Deadly-pro/Omni-RISC/docs/diagrams/architecture.vivado.png

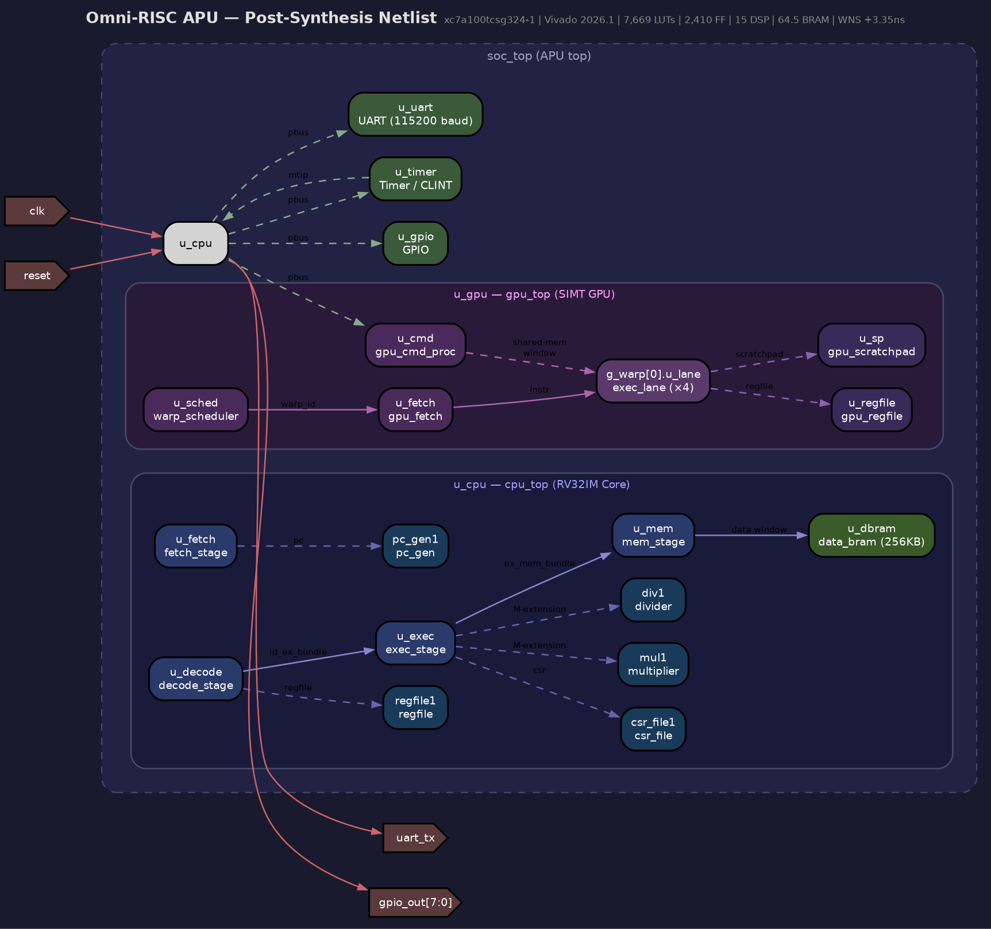
docs/diagrams/architecture.vivado.png
