Deadly-pro/Omni-RISC/hardware/rtl/gpu/gpu_cmd_proc.v

// Omni-RISC APU — GPU Command Processor
//
// Receives commands from CPU via PBUS, launches warps on GPU, and hosts the
// shared-memory window: the CPU writes kernel inputs into warp0's scratchpad
// and reads results back through HOST_DATA. Writes complete on the PBUS store
// before LAUNCH is issued (acquire for the GPU); the CPU polls active_warps to
// zero before reading results (release from the GPU).
module gpu_cmd_proc (
    input         clk,
    input         reset,
    // PBUS interface (from CPU)
    input  [31:0] pbus_addr,
    input  [31:0] pbus_wdata,
    input  [3:0]  pbus_wen,
    input         pbus_read,
    output [31:0] pbus_rdata,
    output        pbus_ready,
    // warp scheduler interface
    output [31:0] cmd_warp_pc,
    output [1:0]  cmd_warp_id,
    output        cmd_launch,
    // status
    input  [3:0]  active_warps,
    // completion interrupt: level-high when a warp just finished; cleared
    // on STATUS read (so the ISR reads STATUS, then clears msip = 0)
    output        gpu_done,
    // shared-memory window into warp0's scratchpad (128-bit = 4 lanes at one
    // word index: [31:0]=lane0, [63:32]=lane1, [95:64]=lane2, [127:96]=lane3)
    input  [127:0] host_rdata,
    output [7:0]  host_raddr,
    output [1:0]  host_wbank,
    output [7:0]  host_waddr,
    output reg [31:0] host_wdata,
    output reg        host_wen,
    // Kernel load port into gpu_fetch's imem (see the address map below).
    output        imem_we,
    output [9:0]  imem_addr,
    output [15:0] imem_data,
    // Base address for the GPU's global memory accesses (LDG/STG). The CPU points
    // the GPU at one of its own buffers; kernels then use small offsets.
    output [31:0] mem_base,
    // Debug visibility for the global-memory handshake (read at +0x30/+0x34):
    // how many transactions were started, and the live state bits. Without these
    // a stuck LDG/STG is indistinguishable from one that silently never issued.
    input  [31:0] dbg_starts,
    input  [31:0] dbg_state,
    input  [31:0] dbg_last
);

    // Command registers (memory-mapped at 0x4000_2000)
    // 0x4000_2000: warp_pc[0]
    // 0x4000_2004: warp_pc[1]
    // 0x4000_2008: warp_pc[2]
    // 0x4000_200C: warp_pc[3]
    // 0x4000_2010: launch (bit[31] = go, bit[1:0] = warp_id)
    // 0x4000_2014: result (warp0 scratchpad word 0 readback)
    // 0x4000_2018: host_win ({bank[1:0], word[7:0]} for shared-memory access)
    // 0x4000_201C: host_data (write -> scratchpad store; read -> scratchpad load)
    // 0x4000_2020: status (unlisted -> returns active_warps)
    // 0x4000_2024: imem_addr (RW, 10-bit word index)
    // 0x4000_2028: imem_data (W: write this 16-bit word to imem_addr, then
    //              auto-increment the address - a memcpy loop pushes the image)
    // 0x4000_202C: mem_base (RW: base address for LDG/STG global accesses)
    // 0x4000_2030: dbg_starts (RO: global transactions started)
    // 0x4000_2034: dbg_state  (RO: {g_is_load, g_busy, g_done, mem_wen!=0})
    reg [31:0] warp_pc [0:3];
    reg        launch_pending;
    reg [1:0]  launch_warp_id;
    reg [9:0]  host_win;
    reg [9:0]  imem_addr_r;
    reg [31:0] mem_base_r;

    // done latch: set when active_warps goes 1->0, combinational-clear on read
    reg        gpu_done_latch;
    reg        was_busy;
    wire       gpu_done_clear = pbus_read && (pbus_addr[5:0] == 6'h20);

    always @(posedge clk) begin
        if (reset) begin
            gpu_done_latch <= 1'b0;
            was_busy       <= 1'b0;
        end else begin
            was_busy <= |active_warps;
            if (gpu_done_clear)
                gpu_done_latch <= 1'b0;
            else if (was_busy && !(|active_warps))
                gpu_done_latch <= 1'b1;
        end
    end
    // combinational so the ISR's read-STATUS clears the latch before the
    // write to msip (even though the register clears on the next edge)
    assign gpu_done = gpu_done_latch & ~gpu_done_clear;

    assign pbus_ready = 1'b1;

    always @(posedge clk) begin
        if (reset) begin
            warp_pc[0] <= 32'b0;
            warp_pc[1] <= 32'b0;
            warp_pc[2] <= 32'b0;
            warp_pc[3] <= 32'b0;
            launch_pending <= 1'b0;
            launch_warp_id <= 2'b0;
            host_win       <= 10'b0;
            host_wen       <= 1'b0;
            host_wdata     <= 32'b0;
            imem_addr_r    <= 10'b0;
            mem_base_r     <= 32'b0;
        end else begin
            launch_pending <= 1'b0;
            host_wen       <= 1'b0;
            // 6-bit decode (was 5): the imem registers live at +0x24/+0x28, and a
            // 5-bit decode would alias +0x20 onto warp_pc[0].
            if (|pbus_wen && pbus_addr[31:6] == 26'h1000080) begin
                case (pbus_addr[5:0])
                    6'h00: warp_pc[0] <= pbus_wdata;
                    6'h04: warp_pc[1] <= pbus_wdata;
                    6'h08: warp_pc[2] <= pbus_wdata;
                    6'h0C: warp_pc[3] <= pbus_wdata;
                    6'h10: begin
                        if (pbus_wen[3]) begin
                            launch_pending <= pbus_wdata[31];  // go bit
                            launch_warp_id <= pbus_wdata[1:0]; // warp_id
                        end
                    end
                    6'h18: host_win <= pbus_wdata[9:0];   // bank + word select
                    6'h1C: begin
                        host_wdata <= pbus_wdata;
                        host_wen   <= 1'b1;               // store into scratchpad
                    end
                    6'h24: imem_addr_r <= pbus_wdata[9:0];
                    6'h28: imem_addr_r <= imem_addr_r + 10'b1;   // auto-increment
                    6'h2C: mem_base_r  <= pbus_wdata;
                    default: ;
                endcase
            end
        end
    end

    assign cmd_warp_pc  = warp_pc[launch_warp_id];
    assign cmd_warp_id  = launch_warp_id;
    assign cmd_launch   = launch_pending;

    // shared-memory window outputs (warp0 scratchpad)
    assign host_raddr  = host_win[7:0];
    assign host_wbank  = host_win[9:8];
    assign host_waddr  = host_win[7:0];

    // Kernel load port. imem_we is combinational off the same decode the write
    // block uses, so a store to IMEM_DATA lands in the array on that edge.
    assign imem_addr = imem_addr_r;
    assign imem_data = pbus_wdata[15:0];
    assign imem_we   = (|pbus_wen) && (pbus_addr[31:6] == 26'h1000080) &&
                       (pbus_addr[5:0] == 6'h28);
    assign mem_base  = mem_base_r;

    // readback
    wire [31:0] rdata_0 = warp_pc[0];
    wire [31:0] rdata_1 = warp_pc[1];
    wire [31:0] rdata_2 = warp_pc[2];
    wire [31:0] rdata_3 = warp_pc[3];
    wire [31:0] rdata_10 = {launch_pending, 29'b0, launch_warp_id};
    wire [31:0] rdata_14 = host_rdata[31:0];   // warp0 scratchpad word 0 readback
    wire [31:0] rdata_18 = {22'b0, host_win};
    wire [31:0] rdata_1C = host_rdata[host_win[9:8]*32 +: 32]; // lane word read
    wire [31:0] rdata_def = {28'b0, active_warps};

    assign pbus_rdata = (pbus_addr[31:6] != 26'h1000080) ? 32'b0 :
                        (pbus_addr[5:0] == 6'h00) ? rdata_0 :
                        (pbus_addr[5:0] == 6'h04) ? rdata_1 :
                        (pbus_addr[5:0] == 6'h08) ? rdata_2 :
                        (pbus_addr[5:0] == 6'h0C) ? rdata_3 :
                        (pbus_addr[5:0] == 6'h10) ? rdata_10 :
                        (pbus_addr[5:0] == 6'h14) ? rdata_14 :
                        (pbus_addr[5:0] == 6'h18) ? rdata_18 :
                        (pbus_addr[5:0] == 6'h1C) ? rdata_1C :
                        (pbus_addr[5:0] == 6'h24) ? {22'b0, imem_addr_r} :
                        (pbus_addr[5:0] == 6'h2C) ? mem_base_r :
                        (pbus_addr[5:0] == 6'h30) ? dbg_starts :
                        (pbus_addr[5:0] == 6'h34) ? dbg_state :
                        (pbus_addr[5:0] == 6'h38) ? dbg_last :
                        rdata_def;

endmodule
