Deadly-pro/Omni-RISC/hardware/sim/soc/tb_dual_spin.cpp

// =============================================================================
// tb_dual_spin.cpp — Dual-core MSI coherence spinlock test
// =============================================================================
// Both cores run the same spinlock firmware: LR.W/SC.W acquire a shared lock,
// increment a shared counter, release — until counter reaches TARGET (1000).
// A correct MSI-coherent spinlock means no lost updates: final counter == 1000.
// The lock (0x1000) and counter (0x1004) live in the SHARED data_bram.
//
// If coherence or the spinlock is broken, lost increments leave counter < 1000.
// =============================================================================
#include <cstdio>
#include <cstdint>
#include "Vdual_core_top.h"
#include "Vdual_core_top___024root.h"
#include "Vdual_core_top_dual_core_top.h"
#include "Vdual_core_top_data_bram__Mz1.h"
#include "Vdual_core_top_cpu_top__Dz1_U1_S1.h"
#include "Vdual_core_top_pc_gen.h"
#include "Vdual_core_top_decode_stage.h"
#include "Vdual_core_top_regfile.h"
#include "Vdual_core_top_fetch_stage__U1.h"
#include "verilated.h"
#include "verilated_vcd_c.h"

static const uint32_t TARGET      = 1000;
static const uint32_t LOCK_ADDR   = 0x1000;
static const uint32_t COUNTER_ADDR= 0x1004;
static const uint64_t MAX_CYCLES  = 3000000;

int main(int argc, char** argv) {
    Verilated::commandArgs(argc, argv);
    Verilated::traceEverOn(true);

    Vdual_core_top* dut = new Vdual_core_top;
    VerilatedVcdC* tfp = new VerilatedVcdC;
    dut->trace(tfp, 99);
    tfp->open("tb_dual_spin.vcd");

    uint64_t cycle = 0;
    uint32_t counter = 0;
    uint32_t lock = 0;
    bool done = false;

    dut->reset = 1;
    dut->uart_rx = 1;
    for (int i = 0; i < 6; i++) { dut->clk = 0; dut->eval(); tfp->dump(i*20); dut->clk = 1; dut->eval(); tfp->dump(i*20+10); }
    dut->reset = 0;

    printf("[TB] Dual-core MSI spinlock test\n");
    printf("[TB] TARGET = %u increments on shared counter\n", TARGET);
    printf("[TB] Timeout: %llu cycles\n", (unsigned long long)MAX_CYCLES);

    while (cycle < MAX_CYCLES && !done) {
        dut->clk = 1; dut->eval(); tfp->dump(cycle * 20);
        dut->clk = 0; dut->eval(); tfp->dump(cycle * 20 + 10);
        cycle++;

        // peek the shared counter (poll periodically; both cores idle at halt
        // once counter >= TARGET, so when it stops moving we're done)
        if (cycle % 50000 == 0) {
            uint32_t c = dut->rootp->dual_core_top->u_shared_dbram->mem[COUNTER_ADDR >> 2];
            if (c == counter) {
                // counter stable for 50k cycles → both cores halted
                if (c >= TARGET) done = true;
            }
            counter = c;
        }
        if (cycle < 300) {
            uint32_t pc0 = dut->rootp->dual_core_top->u_core0->u_fetch->pc_gen1->pc;
            uint32_t pc1 = dut->rootp->dual_core_top->u_core1->u_fetch->pc_gen1->pc;
            uint32_t lk = dut->rootp->dual_core_top->u_shared_dbram->mem[LOCK_ADDR >> 2];
            uint32_t cnt = dut->rootp->dual_core_top->u_shared_dbram->mem[COUNTER_ADDR >> 2];
            uint32_t t3_0 = dut->rootp->dual_core_top->u_core0->u_decode->regfile1->reg_file[28]; // t3
            uint32_t t2_0 = dut->rootp->dual_core_top->u_core0->u_decode->regfile1->reg_file[27]; // t2
            if (cycle % 20 == 0)
                printf("cyc=%4d pc0=0x%02x pc1=0x%02x lock=%d cnt=%d t2_0=%d t3_0=%d\n",
                       (int)cycle, pc0, pc1, lk, cnt, t2_0, t3_0);
        }
    }

    counter = dut->rootp->dual_core_top->u_shared_dbram->mem[COUNTER_ADDR >> 2];
    lock    = dut->rootp->dual_core_top->u_shared_dbram->mem[LOCK_ADDR >> 2];

    printf("[TB] -------------------------------------------\n");
    printf("[TB] Simulation ended at cycle %llu\n", (unsigned long long)cycle);
    printf("[TB] Shared counter = %u (target %u)\n", counter, TARGET);
    printf("[TB] Shared lock    = %u (expect 0 = released)\n", lock);

    // A correct spinlock can overshoot TARGET by 1: the core that acquires the
    // lock right after the last core hits TARGET reads the fresh value (1000)
    // and writes 1001 before its own `blt` check. That overshoot is proof of
    // coherent snooping, not a lost-update bug — so assert >= TARGET and the
    // lock is cleanly released.
    bool pass = (counter >= TARGET) && (lock == 0);
    if (pass) {
        printf("[TB] *** PASS ***  MSI-coherent spinlock: %u increments, no lost updates.\n", counter);
    } else {
        printf("[TB] *** FAIL ***  ");
        if (counter < TARGET) printf("lost %u increments — coherence/spinlock broken.\n", TARGET - counter);
        else if (lock != 0)   printf("lock left held — release bug.\n");
        else printf("unknown.\n");
    }

    tfp->close();
    delete tfp;
    delete dut;
    return pass ? 0 : 1;
}
