Deadly-pro/Omni-RISC/hardware/sim/cpu/tb_cpu_top.cpp

// =============================================================================
// tb_cpu_top.cpp — Integration testbench for the Omni-RISC 5-stage CPU
// =============================================================================
// Two independent phases, each a fresh CPU instance loaded with its own
// hand-verified program (assembled with riscv-none-elf-as, encodings embedded):
//
//   PHASE 1 — First boot / control flow
//     Straight-line ALU, JAL link value, taken BEQ, and BOTH wrong-path kills
//     (decode flush + fetch squash). x28-x31 are canaries: nonzero = a squashed
//     instruction escaped and retired.
//
//   PHASE 2 — Memory subsystem (LSU + data_bram + WB load aligner)
//     SW/LW word round trip, LB/LBU/LH/LHU sign- and zero-extension, and
//     byte/half store-lane masking (SB/SH must touch only their lanes, leaving
//     the rest of the word intact). This is the first real exercise of the
//     load/store decode path, EX address gen, and the Option-B split where the
//     raw word rides BRAM->WB and the aligner slices it in WB.
//
// Both phases peek the architectural regfile through the Verilator hierarchy
// (reg_file is marked /* verilator public */).
// =============================================================================

#include <cstdio>
#include <cstdint>
#include "Vcpu_top.h"
#include "Vcpu_top___024root.h"
#include "Vcpu_top_cpu_top.h"
#include "Vcpu_top_decode_stage.h"
#include "Vcpu_top_regfile.h"
#include "Vcpu_top_mem_stage.h"
#include "Vcpu_top_data_bram.h"
#include "verilated.h"
#include "verilated_vcd_c.h"

#ifndef VCD_FILE
#define VCD_FILE "tb_cpu_top.vcd"
#endif

static int checks = 0;
static int fails = 0;

// -----------------------------------------------------------------------------
// A single CPU instance with its own trace. program.hex must exist on disk
// BEFORE the model is constructed — $readmemh runs in instr_bram's initial
// block at time zero.
// -----------------------------------------------------------------------------
struct Sim {
    VerilatedContext* ctx;
    Vcpu_top*         dut;
    VerilatedVcdC*    tfp;
    vluint64_t        t = 0;

    Sim(const char* vcd) {
        // Each instance gets its own context — Verilator refuses to trace two
        // models through one shared (default) context.
        ctx = new VerilatedContext;
        ctx->traceEverOn(true);
        dut = new Vcpu_top(ctx);
        tfp = new VerilatedVcdC;
        dut->trace(tfp, 99);
        tfp->open(vcd);
    }
    ~Sim() { tfp->close(); delete tfp; delete dut; delete ctx; }

    void tick() {
        dut->clk = 0; dut->eval(); tfp->dump(t++);
        dut->clk = 1; dut->eval(); tfp->dump(t++);
    }
    void run(int reset_cyc, int run_cyc) {
        dut->reset = 1;
        for (int i = 0; i < reset_cyc; i++) tick();
        dut->reset = 0;
        for (int i = 0; i < run_cyc; i++) tick();
    }
    uint32_t reg(int idx) {
        // root -> cpu_top -> u_decode -> regfile1 -> reg_file[idx]
        return dut->rootp->cpu_top->u_decode->regfile1->reg_file[idx];
    }
    uint32_t mem(int idx) {
        // root -> cpu_top -> u_mem -> u_dbram -> mem[idx]
        return dut->rootp->cpu_top->u_mem->u_dbram->mem[idx];
    }
};

static void write_hex(const uint32_t* prog, int n) {
    FILE* f = fopen("program.hex", "w");
    if (!f) { printf("ERROR: cannot write program.hex\n"); exit(2); }
    for (int i = 0; i < 1024; i++)
        fprintf(f, "%08X\n", i < n ? prog[i] : 0x00000013u); // NOP fill
    fclose(f);
}

static void check_reg(Sim& s, int idx, uint32_t expect, const char* why) {
    checks++;
    uint32_t got = s.reg(idx);
    if (got != expect) {
        fails++;
        printf("FAIL  x%-2d = 0x%08X, expected 0x%08X  (%s)\n", idx, got, expect, why);
    } else {
        printf("pass  x%-2d = 0x%08X  (%s)\n", idx, got, why);
    }
}

static void check_mem(Sim& s, int idx, uint32_t expect, const char* why) {
    checks++;
    uint32_t got = s.mem(idx);
    if (got != expect) {
        fails++;
        printf("FAIL  mem[0x%03X] = 0x%08X, expected 0x%08X  (%s)\n", idx*4, got, expect, why);
    } else {
        printf("pass  mem[0x%03X] = 0x%08X  (%s)\n", idx*4, got, why);
    }
}

// -----------------------------------------------------------------------------
// PHASE 1 — control flow / first boot
// -----------------------------------------------------------------------------
static void phase_boot() {
    uint32_t prog[64];
    int i = 0;
    prog[i++] = 0x00500093; // 0x00: addi x1, x0, 5
    prog[i++] = 0x00700113; // 0x04: addi x2, x0, 7
    prog[i++] = 0x00000013; // 0x08: nop            (2-NOP rule: no forwarding)
    prog[i++] = 0x00000013; // 0x0C: nop
    prog[i++] = 0x002081B3; // 0x10: add  x3, x1, x2        -> x3 = 12
    prog[i++] = 0x00C002EF; // 0x14: jal  x5, +12           -> 0x20, link = 0x18
    prog[i++] = 0x11100F93; // 0x18: addi x31, x0, 0x111    POISON (decode-flush slot)
    prog[i++] = 0x22200F13; // 0x1C: addi x30, x0, 0x222    POISON (fetch-squash slot)
    prog[i++] = 0x00100313; // 0x20: addi x6, x0, 1         JAL target
    prog[i++] = 0x00000013; // 0x24: nop
    prog[i++] = 0x00000013; // 0x28: nop
    prog[i++] = 0x00108663; // 0x2C: beq  x1, x1, +12       taken -> 0x38
    prog[i++] = 0x33300E93; // 0x30: addi x29, x0, 0x333    POISON (decode-flush slot)
    prog[i++] = 0x44400E13; // 0x34: addi x28, x0, 0x444    POISON (fetch-squash slot)
    prog[i++] = 0x00900393; // 0x38: addi x7, x0, 9         branch target
    write_hex(prog, i);

    Sim s(VCD_FILE);
    s.run(3, 80);

    printf("\n--- PHASE 1: control flow ---\n");
    check_reg(s,  0, 0x00000000, "x0 is hardwired zero");
    check_reg(s,  1, 0x00000005, "addi x1, x0, 5");
    check_reg(s,  2, 0x00000007, "addi x2, x0, 7");
    check_reg(s,  3, 0x0000000C, "add x3, x1, x2 — first-boot check");
    check_reg(s,  5, 0x00000018, "JAL link = pc+4 via WB jump mux");
    check_reg(s,  6, 0x00000001, "instruction at JAL target executed");
    check_reg(s,  7, 0x00000009, "instruction at BEQ target executed");
    check_reg(s, 31, 0x00000000, "JAL wrong-path #1 killed by decode flush");
    check_reg(s, 30, 0x00000000, "JAL wrong-path #2 killed by fetch squash");
    check_reg(s, 29, 0x00000000, "BEQ wrong-path #1 killed by decode flush");
    check_reg(s, 28, 0x00000000, "BEQ wrong-path #2 killed by fetch squash");
}

// -----------------------------------------------------------------------------
// PHASE 2 — memory subsystem (assembled from /tmp/ldst.S, encodings verified)
//   base x1 = 0x100.  Word A = 0x12345678, Word B = 0xFFFFFF80 (-128).
// -----------------------------------------------------------------------------
static void phase_mem() {
    uint32_t prog[64];
    int i = 0;
    prog[i++] = 0x10000093; // li   x1, 0x100          base addr
    prog[i++] = 0x00000013; // nop
    prog[i++] = 0x00000013; // nop
    prog[i++] = 0x12345137; // lui  x2, 0x12345
    prog[i++] = 0x00000013; // nop   (space lui->addi: no forwarding yet)
    prog[i++] = 0x00000013; // nop
    prog[i++] = 0x67810113; // addi x2, x2, 0x678       x2 = 0x12345678
    prog[i++] = 0x00000013; // nop
    prog[i++] = 0x00000013; // nop
    prog[i++] = 0x0020A023; // sw   x2, 0(x1)           mem[A] = 0x12345678
    prog[i++] = 0x00000013; // nop
    prog[i++] = 0x00000013; // nop
    prog[i++] = 0x0000A183; // lw   x3, 0(x1)           0x12345678
    prog[i++] = 0x0000C203; // lbu  x4, 0(x1)           0x00000078
    prog[i++] = 0x0030C283; // lbu  x5, 3(x1)           0x00000012
    prog[i++] = 0x0020D303; // lhu  x6, 2(x1)           0x00001234
    prog[i++] = 0x00000013; // nop
    prog[i++] = 0x00000013; // nop
    prog[i++] = 0xF8000393; // li   x7, -128            0xFFFFFF80
    prog[i++] = 0x00000013; // nop
    prog[i++] = 0x00000013; // nop
    prog[i++] = 0x0070A223; // sw   x7, 4(x1)           mem[B] = 0xFFFFFF80
    prog[i++] = 0x00000013; // nop
    prog[i++] = 0x00000013; // nop
    prog[i++] = 0x00408403; // lb   x8,  4(x1)          0xFFFFFF80  (sign)
    prog[i++] = 0x0040C483; // lbu  x9,  4(x1)          0x00000080  (zero)
    prog[i++] = 0x00409503; // lh   x10, 4(x1)          0xFFFFFF80  (sign)
    prog[i++] = 0x0040D583; // lhu  x11, 4(x1)          0x0000FF80  (zero)
    prog[i++] = 0x00000013; // nop
    prog[i++] = 0x00000013; // nop
    prog[i++] = 0x0AB00613; // li   x12, 0xAB
    prog[i++] = 0x00000013; // nop
    prog[i++] = 0x00000013; // nop
    prog[i++] = 0x00C080A3; // sb   x12, 1(x1)          byte1 lane only
    prog[i++] = 0x00000013; // nop
    prog[i++] = 0x00000013; // nop
    prog[i++] = 0x0000A683; // lw   x13, 0(x1)          0x1234AB78
    prog[i++] = 0x00000013; // nop
    prog[i++] = 0x00000013; // nop
    prog[i++] = 0xFFF00713; // li   x14, -1             0xFFFFFFFF
    prog[i++] = 0x00000013; // nop
    prog[i++] = 0x00000013; // nop
    prog[i++] = 0x00E0A423; // sw   x14, 8(x1)          mem[C] = 0xFFFFFFFF
    prog[i++] = 0x00000013; // nop
    prog[i++] = 0x00000013; // nop
    prog[i++] = 0x12300793; // li   x15, 0x123
    prog[i++] = 0x00000013; // nop
    prog[i++] = 0x00000013; // nop
    prog[i++] = 0x00F09423; // sh   x15, 8(x1)          low half lane only
    prog[i++] = 0x00000013; // nop
    prog[i++] = 0x00000013; // nop
    prog[i++] = 0x0080A803; // lw   x16, 8(x1)          0xFFFF0123
    prog[i++] = 0x00000013; // nop
    prog[i++] = 0x00000013; // nop
    prog[i++] = 0x0000006F; // halt: j halt
    write_hex(prog, i);

    Sim s("tb_cpu_top_mem.vcd");
    s.run(3, 130);

    printf("\n--- PHASE 2: memory subsystem ---\n");
    check_reg(s,  1, 0x00000100, "base address in x1");
    check_reg(s,  2, 0x12345678, "word A built in x2");
    check_reg(s,  3, 0x12345678, "LW  full-word round trip");
    check_reg(s,  4, 0x00000078, "LBU byte0 zero-extend");
    check_reg(s,  5, 0x00000012, "LBU byte3 zero-extend");
    check_reg(s,  6, 0x00001234, "LHU half@2 zero-extend");
    check_reg(s,  7, 0xFFFFFF80, "word B (-128) built in x7");
    check_reg(s,  8, 0xFFFFFF80, "LB  byte 0x80 SIGN-extend");
    check_reg(s,  9, 0x00000080, "LBU byte 0x80 zero-extend");
    check_reg(s, 10, 0xFFFFFF80, "LH  half 0xFF80 SIGN-extend");
    check_reg(s, 11, 0x0000FF80, "LHU half 0xFF80 zero-extend");
    check_reg(s, 13, 0x1234AB78, "SB wrote lane 1 only (rest preserved)");
    check_reg(s, 16, 0xFFFF0123, "SH wrote low half only (high preserved)");
}

// -----------------------------------------------------------------------------
// PHASE 3 — forwarding network (NO NOP crutches; assembled from /tmp/fwd.S)
//   Every dependent instruction sits back-to-back with its producer, so a
//   broken forward path lands the wrong value in the destination register.
//   Load-use is deliberately absent (no hazard unit yet) — this is pure
//   register-to-register EX/MEM and MEM/WB forwarding, plus branch-operand fwd.
// -----------------------------------------------------------------------------
static void phase_forward() {
    uint32_t prog[64];
    int i = 0;
    prog[i++] = 0x00A00093; // 0x00 addi x1,x0,10
    prog[i++] = 0x00108133; // 0x04 add  x2,x1,x1     EX/MEM fwd, both ports  ->20
    prog[i++] = 0x00100193; // 0x08 addi x3,x0,1
    prog[i++] = 0x00118213; // 0x0C addi x4,x3,1       chained d1 ->2
    prog[i++] = 0x00120293; // 0x10 addi x5,x4,1       chained d1 ->3
    prog[i++] = 0x00128313; // 0x14 addi x6,x5,1       chained d1 ->4
    prog[i++] = 0x06400393; // 0x18 addi x7,x0,100
    prog[i++] = 0x00000413; // 0x1C addi x8,x0,0       filler (push x7 to MEM/WB)
    prog[i++] = 0x007384B3; // 0x20 add  x9,x7,x7      MEM/WB fwd, both ports ->200
    prog[i++] = 0x00500513; // 0x24 addi x10,x0,5      older x10 (-> MEM/WB)
    prog[i++] = 0x00900513; // 0x28 addi x10,x0,9      newer x10 (-> EX/MEM)
    prog[i++] = 0x00050593; // 0x2C addi x11,x10,0     priority: nearest wins ->9
    prog[i++] = 0x00700013; // 0x30 addi x0,x0,7       write to x0 discarded
    prog[i++] = 0x00000613; // 0x34 addi x12,x0,0      x0 never forwards ->0
    prog[i++] = 0x00500693; // 0x38 addi x13,x0,5      branch rs1 (d2 at branch)
    prog[i++] = 0x00700713; // 0x3C addi x14,x0,7      branch rs2 (d1 at branch)
    prog[i++] = 0x00E68463; // 0x40 beq  x13,x14,+8    fwd 5!=7 -> NOT taken
    prog[i++] = 0x07B00793; // 0x44 addi x15,x0,123    runs iff branch not taken
    prog[i++] = 0x03700813; // 0x48 addi x16,x0,55     (branch target)
    prog[i++] = 0x0000006F; // 0x4C j halt
    write_hex(prog, i);

    Sim s("tb_cpu_top_fwd.vcd");
    s.run(3, 90);

    printf("\n--- PHASE 3: forwarding network ---\n");
    check_reg(s,  2, 0x00000014, "EX/MEM fwd both ports: add x2,x1,x1 = 20");
    check_reg(s,  4, 0x00000002, "chained d1 fwd: x4 = 2");
    check_reg(s,  5, 0x00000003, "chained d1 fwd: x5 = 3");
    check_reg(s,  6, 0x00000004, "chained d1 fwd: x6 = 4");
    check_reg(s,  9, 0x000000C8, "MEM/WB fwd both ports: add x9,x7,x7 = 200");
    check_reg(s, 11, 0x00000009, "priority: EX/MEM beats MEM/WB, x11 = 9");
    check_reg(s, 12, 0x00000000, "x0 never forwards: x12 = 0 (not 7)");
    check_reg(s, 15, 0x0000007B, "branch read fwd operands: not taken, x15 = 123");
    check_reg(s, 16, 0x00000037, "branch target reached: x16 = 55");
}

// -----------------------------------------------------------------------------
// PHASE 4 — load-use interlock (hazard_unit; assembled from scratch_lduse.S)
//   Every load is immediately followed by a consumer with NO NOP between them.
//   Forwarding alone can't cover this: the load result doesn't exist until WB,
//   so hazard_unit must stall ONE cycle, after which the MEM/WB forward delivers
//   it. Each case also implicitly proves the load's OWN writeback survived the
//   stall (downstream stages must keep draining while IF/ID freezes).
// -----------------------------------------------------------------------------
static void phase_lduse() {
    uint32_t prog[64];
    int i = 0;
    prog[i++] = 0x10000093; // 0x00 addi x1,x0,0x100  base
    prog[i++] = 0x00000013; // 0x04 nop
    prog[i++] = 0x00000013; // 0x08 nop
    prog[i++] = 0x05500113; // 0x0C addi x2,x0,0x55
    prog[i++] = 0x00000013; // 0x10 nop
    prog[i++] = 0x00000013; // 0x14 nop
    prog[i++] = 0x0020A023; // 0x18 sw   x2,0(x1)     mem[0x100]=0x55
    prog[i++] = 0x00000013; // 0x1C nop
    prog[i++] = 0x00000013; // 0x20 nop
    prog[i++] = 0x0000A183; // 0x24 lw   x3,0(x1)     x3<-0x55
    prog[i++] = 0x00118213; // 0x28 addi x4,x3,1      CASE A: stall+fwd -> 0x56
    prog[i++] = 0x00000013; // 0x2C nop
    prog[i++] = 0x00000013; // 0x30 nop
    prog[i++] = 0x0000A283; // 0x34 lw   x5,0(x1)     x5<-0x55
    prog[i++] = 0x00500333; // 0x38 add  x6,x0,x5     CASE B: rs2 dep -> 0x55
    prog[i++] = 0x00000013; // 0x3C nop
    prog[i++] = 0x00000013; // 0x40 nop
    prog[i++] = 0x0000A383; // 0x44 lw   x7,0(x1)     x7<-0x55
    prog[i++] = 0x40138433; // 0x48 sub  x8,x7,x1     CASE C: 0x55-0x100 = 0xFFFFFF55
    prog[i++] = 0x00000013; // 0x4C nop
    prog[i++] = 0x00000013; // 0x50 nop
    prog[i++] = 0x0000A483; // 0x54 lw   x9,0(x1)     x9<-0x55
    prog[i++] = 0x05500513; // 0x58 addi x10,x0,0x55
    prog[i++] = 0x00A48463; // 0x5C beq  x9,x10,+8    CASE D: fwd 0x55==0x55 -> taken
    prog[i++] = 0x0AA00593; // 0x60 addi x11,x0,0xAA  skipped iff taken correctly
    prog[i++] = 0x03300613; // 0x64 addi x12,x0,0x33  branch target
    prog[i++] = 0x0000006F; // 0x68 j halt
    write_hex(prog, i);

    Sim s("tb_cpu_top_lduse.vcd");
    s.run(3, 120);

    printf("\n--- PHASE 4: load-use interlock ---\n");
    check_reg(s,  3, 0x00000055, "CASE A: load x3 wrote back (downstream drained)");
    check_reg(s,  4, 0x00000056, "CASE A: stall+MEM/WB fwd, x4 = x3+1 = 0x56");
    check_reg(s,  5, 0x00000055, "CASE B: load x5 wrote back");
    check_reg(s,  6, 0x00000055, "CASE B: rs2 dep interlock, x6 = x5 = 0x55");
    check_reg(s,  7, 0x00000055, "CASE C: load x7 wrote back");
    check_reg(s,  8, 0xFFFFFF55, "CASE C: sub x8 = 0x55 - 0x100 = 0xFFFFFF55");
    check_reg(s, 11, 0x00000000, "CASE D: branch taken on fwd operand, x11 skipped");
    check_reg(s, 12, 0x00000033, "CASE D: branch target reached, x12 = 0x33");
}
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
