Deadly-pro/Omni-RISC/hardware/sim/cpu/tb_decode_stage.cpp

// =============================================================================
// tb_decode_stage.cpp — Verilator testbench for Omni-RISC ID stage
// =============================================================================
//
// DUT: decode_stage (hardware/rtl/cpu/core/decode_stage.v)
//      instantiates decoder (+imm_gen) + regfile internally
//
// Strategy: preload registers through the WB write port (the same path
// wb_stage will use), then present hand-encoded RV32I instructions on
// if_id_instr and check the full ID/EX bundle one cycle later.
//
// Tests:
//   1. Reset bubbles the control bits
//   2. WB port writes reach the regfile (preload x1, x2)
//   3. R-type:  add  x3, x1, x2   — operands read, control bits, rd
//   4. I-type:  addi x4, x1, -5   — sign-extended immediate, op_type=1
//   5. Load:    lw   x6, 8(x1)    — mem_read, funct3=010
//   6. Store:   sw   x2, 12(x1)   — mem_write, reg_write=0, S-imm,
//                                    rs2_data carries the store value
//   7. Branch:  beq  x1, x2, +16  — branch=1, B-imm, op_type=3
//   8. Jump:    jal  x1, +16      — jump=1, reg_write=1, J-imm, pc_plus4
//   9. x0 reads as zero even after a write attempt
//  10. Flush bubbles a live instruction (control=0)
//  11. Flush wins over stall
//  12. Stall bubbles ID/EX (load-use interlock inserts a NOP into EX),
//      Hold preserves ID/EX (div-stall keeps the div resident in EX)
// =============================================================================

#include <cstdio>
#include <cstdint>
#include <cstdlib>

#include "Vdecode_stage.h"
#include "verilated.h"
#include "verilated_vcd_c.h"

static const uint32_t NOP = 0x00000013;

// Hand-assembled RV32I (verified against the ISA manual bit layouts)
static const uint32_t ADD_X3_X1_X2   = 0x002081B3; // add  x3, x1, x2
static const uint32_t ADDI_X4_X1_M5  = 0xFFB08213; // addi x4, x1, -5
static const uint32_t LW_X6_8_X1     = 0x0080A303; // lw   x6, 8(x1)
static const uint32_t SW_X2_12_X1    = 0x0020A623; // sw   x2, 12(x1)
static const uint32_t BEQ_X1_X2_16   = 0x00208863; // beq  x1, x2, +16
static const uint32_t JAL_X1_16      = 0x010000EF; // jal  x1, +16
static const uint32_t ADD_X3_X0_X0   = 0x000001B3; // add  x3, x0, x0

static const uint32_t X1_VAL = 0x11111111;
static const uint32_t X2_VAL = 0x22222222;

// ---------------------------------------------------------------------------
// Clock helpers
// ---------------------------------------------------------------------------
static vluint64_t sim_time = 0;

static void tick(Vdecode_stage* dut, VerilatedVcdC* tfp) {
    dut->clk = 0;
    dut->eval();
    tfp->dump(sim_time++);

    dut->clk = 1;
    dut->eval();
    tfp->dump(sim_time++);
}
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
