Deadly-pro/Omni-RISC/(commit log)

2026-03-11 Bug fix in jump instruction
    Fixed bug due to jump instruction
    [soc_top.v]
2026-07-01 Project restructure: Omni-RISC APU (CPU + GPU + Accelerators)
    - Complete directory structure: 70+ RTL placeholders, firmware skeleton,
    model track stubs, docs, scripts
    - Full test infrastructure: Verilator testbenches (ALU, decoder, regfile,
    cache, GShare, ROB, SoC UART, SoC timer, SoC GPU dispatch)
    - Simulation driver (run_sim.sh), compliance test runner, hex converters
    - Build system: top-level Makefile, firmware cross-compilation Makefile,
    linker script for RV32IM bare-metal
    - Old barrel processor SoC archived on branch archive/old-barrel-soc
2026-07-16 Restructure to in-order RV32IM scope; implement and verify datapath leaf modules
    Repo rework: archive OoO + fixed-function accelerator scope, rewrite docs
    (architecture, cpu_design 10-step bring-up, reading notes) for the 5-stage
    in-order Path A plan.
    Implemented and testbench-verified:
    - alu (42/42), regfile (41/41), imm_gen + decoder (47/47),
    pc_gen (19/19), branch_unit (25/25)
    - New testbenches: tb_pc_gen, tb_branch_unit
    - TODO.md tracks deferred cleanup (localparams, illegal-instr hardening)
    [alu.v, branch_unit.v, decoder.v, fetch_stage.v, hazard_unit.v, imm_gen.v, mem_stage.v, pc_gen.v]
2026-07-16 Implement fetch stage and instruction BRAM, verified 33/33
    - instr_bram: synchronous read with enable gating (maps to BRAM ENA),
    word-indexed via pc[11:2], $readmemh init
    - fetch_stage: pc_gen + instr_bram + IF/ID register; registered squash
    flag NOPs dead-path fetches on reset/redirect/trap; stall freezes
    pc, pc_plus4, and the BRAM read together via read-enable
    - tb_fetch_stage: self-identifying test program (imm encodes word index)
    catches any pc/instruction desync; covers reset, sequential lockstep,
    redirect squash, stall hold (no NOP injection), trap squash
    [fetch_stage.v, instr_bram.v, tb_fetch_stage.cpp]
2026-07-18 Implement decode and exec stages; decoder fixes, all TBs passing
    - decoder.v: 47/47 tb_decoder (JALR alu_op, SYSTEM reg_write guard fixed)
    - decode_stage.v + tb_decode_stage: passing
    - exec_stage.v + tb_exec_stage: passing
    [decode_stage.v, decoder.v, exec_stage.v, tb_decode_stage.cpp, tb_exec_stage.cpp]
2026-07-20 Fedora migration: toolchain fixes, all 8 testbenches re-verified
    - regfile: drop declaration-time init on loop var (Verilator 5.046
    PROCASSINIT is warn-as-error under --Wall)
    - tb_fetch_stage: remove unused do_reset helper (gcc16 -Werror)
    - firmware/Makefile: PREFIX now riscv-none-elf- (xPack toolchain,
    Fedora has no riscv32 package); overridable via ?=
    - restore executable bits on run_sim.sh / run_compliance.sh lost in
    the disk salvage
    [regfile.v, tb_fetch_stage.cpp]
2026-07-20 First boot: full 5-stage pipeline executes programs, tb_cpu_top 11/11
    - mem_stage: MEM/WB pipeline register (load path stubbed until LSU)
    - wb_stage: writeback mux (jump ? pc+4 : mem_read ? load : alu)
    - cpu_top: structural closed loop of all five stages; redirect drives
    both fetch squash and decode flush; stall/trap tied off until steps 7/9
    - regfile: write-first read bypass — closes the distance-3 hazard where
    same-edge regfile write and ID/EX capture read stale data; keeps the
    2-NOP contract that step-6 forwarding assumes; tb_regfile still 41/41
    - tb_cpu_top: hand-assembled boot program covering ALU flow, JAL link,
    taken BEQ, and poison canaries in all four wrong-path slots
    [cpu_top.v, mem_stage.v, regfile.v, tb_cpu_top.cpp, wb_stage.v]
2026-07-26 M-extension: multiplier + divider units verified, MUL integrated into pipeline
    - multiplier.v: combinational 32x32->64, extend-then-multiply covers all four
    MUL/MULH/MULHSU/MULHU signedness cases (tb_multiplier 16/16)
    - divider.v: iterative shift-subtract with sign-magnitude wrapper, CLZ-normalized,
    start/busy/done handshake; div-by-zero + INT_MIN/-1 fast paths (tb_divider 60/60)
    - MUL wired through pipeline: is_mul_div propagated ID->EX->result mux, mul reads
    forwarded operands, result forwards out (tb_cpu_top PHASE 5, 48/48 total)
    - forwarding_net + hazard_unit wiring, tb_cpu_top phases 3/4 (fwd + load-use)
    ^- OpenROAD RTL-to-GDSII fallback validation path (FPGA access uncertain)
    Di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
2026-07-26 M-extension: divider integrated into pipeline, tb_cpu_top 59/59
    Multi-cycle divider now runs through the live 5-stage pipeline with a
    div-busy freeze (fetch + decode hold, EX bubbles-then-latches).
    Three integration fixes over the standalone-verified divider:
    - divider.v: DIVIDE loop reads latched b_mag_reg, not live b_mag
    (fwd_rs2_data drains out from under a multi-cycle unit mid-op).
    - exec_stage.v: freeze/bubble on combinational (is_div & ~div_done),
    not registered div_busy which lags the div's arrival in EX by one
    cycle — freezing late loses the div's rd and latches a garbage result.
    tb_cpu_top PHASE 6 covers all four ops, signed/unsigned, both /0 fast
    paths, div-result forward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
    [cpu_top.v, decode_stage.v, divider.v, exec_stage.v, tb_cpu_top.cpp]
2026-07-31 CSR: csr_file integrated into pipeline, tb_cpu_top 70/70
    - decoder emits is_csr (opcode=SYSTEM, funct3!=0); decode_stage pipelines it
    - exec_stage instantiates csr_file: csr_addr from imm[11:0], wdata = fwd rs1,
    uimm = rs1_addr, result mux selects csr_rdata when is_csr
    - csr_file: fix mtvec WARL — store full 32 bits, mask mode bits only at output
    (SET/CLEAR were losing bits [1:0])
    - tb_cpu_top PHASE 7: all six CSRRW/CSRRS/CSRRC +/- I variants through the
    live pipeline incl. write-skip (rs1=x0) and read-old-value checks
    - tb_decode_stage: test 12 updated to current contract (stall=control bubble,
    hold=preserve) — was asserting the pre-divider stall=hold semantics
    [cpu_top.v, csr_file.v, decode_stage.v, decoder.v, exec_stage.v, tb_cpu_top.cpp, tb_csr_file.cpp, tb_decode_stage.cpp]
2026-07-31 Trap unit: ecall/ebreak/illegal/mret integrated, tb_cpu_top 83/83
    - trap_unit (new, combinational): detects exceptions in EX, muxes mtvec/mepc
    as the redirect target, drives the CSR trap write port. Illegal-CSR-access
    (csr_illegal) is folded in as an illegal-instruction cause 2.
    - decoder: distinguishes ecall (funct12=0x000), ebreak (0x001), mret (0x302);
    unknown SYSTEM funct12 now flags illegal_instr
    - decode_stage: pipelines is_ecall/is_ebreak/is_mret/illegal to EX
    - exec_stage: instantiates trap_unit, wires csr_file trap/mret ports, bubbles
    EX/MEM on trap so the trapping instruction never retires
    - cpu_top: flush = redirect | trap; trap_valid/target now real (were tied 0)
    - data_b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
2026-07-31 Compliance: riscv-arch-test rv32im passes 53/54 (1 architectural skip)
    - tests/omni-risc/: DUT target config (rvtest_config.h, rvmodel_macros.h,
    riscv_arch_test.h w/o sail_macros override, link.ld at 1MB base so qemu-user
    can mmap and the 256KB BRAM window wraps cleanly)
    - tests/omni-risc-ref/: qemu/reference macros
    - tests/omni-risc/ref_sim.cpp: small independent RV32IM+Zicsr interpreter
    used as the golden-signature reference (qemu-user semihosting only
    implements SYS_EXIT; its gdb-stub memory reads are unreliable — documented)
    - hardware/sim/cpu/tb_compliance.cpp: DUT harness — loads the test image,
    starts at entry, detects completion via the tohost write, dumps signature
    - d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
    [data_bram.v, decoder.v, instr_bram.v, pc_gen.v]
2026-08-01 SoC: UART + timer/CLINT + GPIO, CPU pbus & machine-timer interrupt, firmware
    - cpu_top exposes a peripheral bus (pbus) for addresses >= 0x40000; data_bram
    owns the low 256KB window (chip-select gated). mem_stage muxes load rdata
    between the BRAM and pbus_rdata; data_bram read is now combinational
    (registered in mem_stage — same 1-cycle latency, bare-CPU tests unaffected)
    - csr_file: mip.MTIP driven by an mtip input (read-only, from the SoC timer);
    mie/mip exposed to the trap unit. trap_unit takes the machine timer
    interrupt (MIE & MTIE & MTIP) with cause 0x80000007
    - peripherals: uart.v (TX 115200-8N1 @50MHz), timer.v (64-bit mtime/mtimecmp,
    mtip = mtime>=mtimecmp), gpio.v (8-b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
2026-08-01 Timer interrupt precision: mepc falls back to the redirect target during a drain
    The timer interrupt could fire while a wrong-path fetch-ahead instruction was
    in EX (the loop `j` fetches ahead into the next .rodata / banner string). mepc
    then captured that data address, so mret jumped into garbage -> illegal trap,
    delaying subsequent interrupts (~78k cycle period variance).
    Fix: exec_stage tracks the last redirect target and a short pending window
    (redirects drain wrong-path instructions for a few cycles). trap_unit uses the
    redirect target as the interrupt's mepc while a redirect is pending, and
    suppresses the interrupt on pure flush bubbles. Exceptions are unaffected
    (mepc stays the trapp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
    [exec_stage.v, trap_unit.v]
2026-08-01 Cache: L1 D-cache (4KB, 2-way, write-through) passes tb_cache 14/14
    - l1_dcache.v: 4KB 2-way set-associative, 32B lines (8 words), 64 sets,
    write-through with write-allocate refill, MMIO bypass (>=0x10000000).
    Request/defer FSM: latches read/write on read_en|write_en, re-checks if a
    new request arrives mid-latch, refills one word per memory ack.
    - tb_cache: the standalone memory interface has no write path, so write-through
    to the backing store is untestable here; removed the dead mem_write() (it
    failed the build with -Werror) and verified write-through via the cache read.
    Verified: tb_cache 14/14 (cold miss/fill/hit, writes, eviction, byte/half/word,
    MMIO bypass).
    [l1_dcache.v, tb_cache.cpp]
2026-08-01 Phase C: L1 I-cache + cache integration (module-verified), compliance restored
    - l1_icache.v: 4KB direct-mapped read-only I-cache, 32B lines, refill FSM,
    fetch-ahead-safe (holds rdata across a freeze via fetch_en). tb_icache 27/27.
    - l1_dcache.v: reset the valid array; drop unused req_read/INDEX_W (clean build).
    - Caches wired into the pipeline behind USE_CACHES (default 0): fetch_stage
    (I$ + instr_bram backing), mem_stage (D$ + data_bram backing, write-through
    via one-shot direct store), cpu_top freeze includes icache_miss/mem_stall and
    exec holds during any refill.
    - mem_stage data_cs: allow the 0x100000-0x13FFFF aliased data window (the
    riscv-arch-test images link at 0x100000 an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
    [cpu_top.v, fetch_stage.v, l1_dcache.v, l1_icache.v, mem_stage.v, soc_top.v, tb_icache.cpp]
2026-08-01 Phase C fix: IF/ID fetch-pairing bug on concurrent I/D refills
    Root cause: on a branch/jump redirect while a D-cache store refill freezes
    the pipeline, pc_gen's PC updates ONE CYCLE LATE, so IF/ID captured the
    fetch-ahead PC paired with the icache's still-stale rdata → corrupted
    instruction/pc pair. The firmware's `main` (jal after stack store) mis-executed.
    Fix (three parts, all in fetch_stage):
    1. IF/ID register captures redirect_target/trap_target directly (not the
    lagging pc) on redirect/trap, so its PC is always correct.
    2. A new `ic_pc` mux feeds the same redirect_target/trap_target to the
    icache during redirects, so its rdata matches IF/ID's PC.
    3. Sticky `flush_q` holds the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
    [fetch_stage.v, tb_2store.cpp]
2026-08-01 Phase D1: Dual-core top with shared bus and MSI snooping
    New files:
    - hardware/rtl/cpu/core/cpu2_top.v — dual-core top with fixed-priority bus arbitration
    - hardware/rtl/cpu/cache/l1_dcache_msi.v — 4KB 2-way MSI snooping D-cache (M/S/I states)
    - hardware/sim/cpu/tb_cpu2.cpp — testbench for dual-core
    Modified:
    - cpu_top.v: added snoop interface ports (snoop_addr, snoop_read, snoop_write, snoop_ack)
    - mem_stage.v: added snoop interface, connected to l1_dcache_msi when USE_CACHES=1
    Architecture:
    - Two cpu_top instances share a peripheral bus via fixed-priority arbiter (core0 > core1)
    - Each core's L1 D-cache snoops the other's bus transactions
    - MSI protocol: on bus read hit with M-stat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
    [cpu2_top.v, cpu_top.v, l1_dcache_msi.v, mem_stage.v, tb_cpu2.cpp]
2026-08-01 Phase D3: MSI snooping cache — handle transient states
    Updated l1_dcache_msi.v with proper handling of:
    - Snoop hit during refill (WAITM_RD) → snoop retried after refill
    - Snoop read hit M → writeback full line (8 words) then M→S
    - Snoop write hit S/M → invalidate to I
    - CPU request vs snoop priority (CPU wins in IDLE/CHECK)
    - Explicit writeback state (WB_M) for eviction of M lines
    - Snoop acknowledge registered for one cycle
    State machine expanded to 8 states:
    IDLE, CHECK, WAITM_RD, WAITM_WR, WB_M, SNOOP_INV, SNOOP_WB
    Transient state SNOOP_WAIT reserved for snoop-during-refill (future hardening).
    All regressions green:
    - tb_cpu_top 83/83
    - compliance 53/54
    - tb_cache 14/14, t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
2026-08-02 Phase D4: A-extension LR/SC — single-core atomic path verified
    LR.W / SC.W end-to-end (decode → exec → mem_stage → MSI D-cache → WB):
    - decoder.v: distinguish LR.W (funct5=00010) from SC.W (funct5=00011);
    LR sets mem_read, SC sets mem_write; other AMOs are illegal
    - exec_stage.v: SC.W's result (0=success/1=fail) rides the load path so WB
    writes the dcache rdata, not the ALU result
    - l1_dcache_msi.v: latch req_is_lr/req_is_sc (the one-shot pulses drop before
    a refill completes); arm the reservation after an LR miss refills
    - mem_stage.v: route the dcache's write-through (mem_write_req) to data_bram
    Verified with tb_lrsc (5/5): LR reads old lock value, SC succeeds, and the
    wri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
    [decoder.v, exec_stage.v, l1_dcache_msi.v, mem_stage.v, tb_lrsc.cpp]
2026-08-02 Phase D4: MSI-coherent dual-core spinlock — shared memory + working LR/SC
    The two cores' L1 D-caches now refill/write-through ONE physical data_bram
    (a fixed-priority arbiter on each core's dcache memory interface), making MSI
    coherence meaningful. MSI snooping watches the OTHER core's dcache memory
    transactions (refills / write-throughs), not the pbus.
    - mem_stage: SHARED_MEM mode — exposes the dcache memory interface (mem_if_*)
    and routes write-throughs to it; internal data_bram stays for harness peeks
    - cpu_top: SHARED_MEM param + mem_if_* ports
    - dual_core_top: shared data_bram + arbiter + snoop on memory transactions
    - decoder: SC.W sets BOTH mem_read+mem_write — the hazard uni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
    [cpu_top.v, decoder.v, dual_core_top.v, mem_stage.v, soc_top.v, tb_dual_min.cpp, tb_dual_spin.cpp]
2026-08-02 Phase D5: MSI litmus verification — message-passing + store-buffering
    Two real MSI coherence bugs found by litmus testing and fixed in l1_dcache_msi:
    1. Snoop starvation: a core's dcache only captured snoops in IDLE/CHECK and
    CPU requests beat snoops in IDLE, so a busy poller (e.g. `lw flag; beqz`
    back-to-back) never processed the other core's write-invalidate → stale
    reads forever. Fix: latch snoops in EVERY state and process the pending
    snoop with priority over CPU requests in IDLE.
    2. Request-pulse loss: the shared-memory arbiter (dual_core_top) could defer a
    core's refill while the other core owned the bus, but the dcache pulsed
    mem_read_req for 1 cycle expecting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
    [l1_dcache_msi.v, tb_litmus_mp.cpp, tb_litmus_sb.cpp]
2026-08-02 Phase E1: SIMT lane datapath units
    4-lane SIMT datapath building blocks, each verified standalone:
    - gpu_alu.v: 4-lane integer ALU (ADD..SRA + MUL-low), CPU op encoding,
    lanes packed 128-bit (lane0=[31:0]). tb_gpu_alu 11/11.
    - gpu_regfile.v: 8 vector regs x 4 lanes x 32b, 2R+1W, r0 hardwired zero.
    tb_gpu_regfile 6/6.
    - gpu_scratchpad.v: 4 banks x 256 words, packed per-lane word address
    (lane0=[7:0]). tb_gpu_scratchpad 6/6.
    - gpu_lsu.v: per-lane effective-address calc + store/load data passthrough.
    Next: E2 exec_lane x 4 (one warp).
    [gpu_alu.v, gpu_lsu.v, gpu_regfile.v, gpu_scratchpad.v]
2026-08-03 Phase E2-E5: GPU SIMT engine complete — scheduler, decode, assembled kernels
    Completes the SIMT engine behind the E1 datapath:
    - warp_scheduler: round-robin fetch/issue, HALT→idle, unconditional branch
    - gpu_decode: full 16-bit SIMT ISA (ALU/ALU2/LSU/BRI/LDI/HALT), lane-level alu_op
    - gpu_top: per-warp exec_lane, load/ldi/alu writeback mux, completion +1
    - exec_lane: exposes rs2 store data (needed by kernel ST)
    - gpu_asm.py: two-pass assembler (labels, regs, imm9, HALT) → $readmemh hex
    - kernels: vector_add, relu, matmul(2x2), conv2d(3-tap 1D) fully unrolled,
    assembled + verified end-to-end in tb_gpu_top_kernels (66/66 across 4 warps)
    - tb_gpu_top: real kernel execution (launch via P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
    [exec_lane.v, gpu_asm.py, gpu_cmd_proc.v, gpu_decode.v, gpu_fetch.v, gpu_lsu.v, gpu_scratchpad.v, gpu_top.v]
2026-08-03 APU: wire SIMT GPU into the SoC as a pbus slave; CPU dispatch + result readback
    Integrates the Phase-E GPU into a single SoC so the CPU can drive it:
    - gpu_scratchpad: a second (host) read port — reads one word index across all
    4 banks, combinational, for CPU visibility
    - exec_lane/gpu_top: thread the host read through; gpu_top exposes warp0
    scratchpad word 0 to the command processor
    - gpu_cmd_proc: +0x14 RESULT readback; status/active_warps on unlisted addrs
    - soc_top: GPU is a pbus slave @0x40002000 (kernel flashed via IMEM_FILE),
    OR'd into the existing rdata decode — existing UART/timer SoC tests unaffected
    - firmware: drivers/gpu.c (launch/wait-idle/result), apps/benchmark_gpu.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
    [benchmark_gpu.c, exec_lane.v, gpu.c, gpu.h, gpu_cmd_proc.v, gpu_scratchpad.v, gpu_top.v, soc_top.v]
2026-08-05 Phase G: BRAM-mappable data_bram + Vivado flow — APU fits XC7A100T
    - data_bram: register the read (rdata <= mem[addr[17:2]]) so the 256KB array
    maps to BRAM (64 RAMB36E1) instead of distributed RAM (was 32,768 LUTs =
    172% of LUT-memory capacity → place_design DRC UTLZ-1). LUT-as-Memory now 0.
    - pipeline timing: mem_stage inserts a 1-cycle mem_hold per data load
    (dbram_hold toggle) and toggles dc_mem_ack for dcache refills; dual_core_top
    toggles per-core read acks. decode_stage gives hold priority over flush so a
    branch/jump frozen in EX by a hold isn't destroyed by its own redirect before
    EX/MEM captures it (fixed tb_soc_gpu "GPU(4444…" bug — link value was lost).
    - ALU: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
    [alu.v, artix7.xdc, data_bram.v, decode_stage.v, dual_core_top.v, exec_stage.v, gpio.v, gpu_top.v]
2026-08-05 Add generated architecture diagram + public-facing README polish
    - scripts/gen_arch_diagram.py: extracts the real module hierarchy from
    hardware/rtl/ and renders an architecture diagram (graphviz dot -> svg/png)
    - docs/diagrams/architecture.{dot,svg,png}: APU (soc_top) + MSI coherence rig
    (dual_core_top) clusters; solid = instantiation, dashed = coherence edge
    - README: diagram, verification table, synth/impl results, build flow, license
    placeholder
2026-08-06 Phase F: shared-memory window — CPU<->GPU coherent data path
    Rewrite the GPU command processor to host a shared-memory window into warp0's
    scratchpad (HOST_WIN/HOST_DATA at +0x18/+0x1C): the CPU writes kernel inputs
    and reads results directly in GPU memory, no copies. STATUS moves to +0x20
    with the readback decode widened to pbus_addr[5:0] (the +0x1D-1F fallthrough
    offsets alias on halfword loads, which GCC emits for 32-bit volatile reads).
    benchmark_gpu now runs a real vector-add: CPU writes A/B, kernel computes C,
    per-lane readback verified C = A + B. tb_soc_gpu PASS (11/22/33/44); full
    regression green (tb_gpu_top_kernels 66/66, tb_cpu_top, tb_dual_spin, litmus
    MP/SB, tb_cache 14/14, t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
    [benchmark_gpu.c, exec_lane.v, gpu.c, gpu.h, gpu_cmd_proc.v, gpu_scratchpad.v, gpu_top.v]
2026-08-06 Phase G: honest synth+impl numbers, RAM-inferable GPU memories
    The prior 6,270 LUT / 10,720 FF / 18 DSP / WNS +1.305ns measurement was an
    artifact: the old gpu_demo.S was an all-constant kernel (LDI/ADD -> sp[0]=42),
    so Vivado constant-folded the entire GPU datapath and its 128Kb of storage,
    and impl had never actually run (that WNS was the synth timing report).
    First real-data (vector-add) measurement blew up to 58,015 LUTs because
    Phase F's host-write port + reset loops broke GPU RAM inference:
    - gpu_scratchpad: one write port per bank, host shares the lane port with
    host priority (coherence protocol guarantees write-before-read)
    - gpu_regfile: drop the reset loop (BRAM/LUTRAM cannot be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
    [data_bram.v, gen_arch_diagram.py, gpu_regfile.v, gpu_scratchpad.v]
2026-08-20 FreeRTOS on Omni-RISC: bring up kernel build, port, testbench and docs
    Adds the FreeRTOS V10.5.1 kernel and RISC-V (CLINT/M-mode) port to the
    firmware tree, with a two-task demo app, a two-region RTOS linker, and a
    Verilator UART testbench that verifies both tasks preempt. Also adds
    hand-assembled core self-checks (load-branch patterns) used to prove the
    RV32IM core is sound while debugging why the scheduler first selected the
    idle task instead of a user task.
    Status: kernel builds and the scheduler starts, but dispatch to the user
    task is still blocked by TCB-memory corruption under simulation (core is
    verified clean). See tests/rtos/status.md.
    💘 Generated with Crush
    Assisted-by: Crus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
2026-08-20 FreeRTOS: document persistent dispatch bug for the next session
    Records the precise, firmware-confirmed symptom (pxCurrentTCB ends up at
    task B instead of staying at task A after task creation), what was ruled
    out (CPU verified via compliance 53/54, tb_cpu_top 83/83, and all
    regressions), and the two RTL fix attempts that were both reverted to
    keep the verified core pristine. Leaves a working VCD-probe recipe and the
    diagnostic signal IDs so the registered-read hazard can be fixed safely.
    Assisted-by: Crush:deepseek-v4-flash
    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
2026-08-20 FreeRTOS: fix the dispatch bug — load's mem_read survives the freeze
    ROOT CAUSE: decode_stage.v gave the hazard load-use stall priority over
    the pipeline freeze (hold). With back-to-back loads, the first load holds
    MEM (mem_hold → mem_stall), the second load sits frozen in EX, and the
    consumer branch in IF/ID triggers the hazard stall — so decode injected a
    bubble into ID/EX, erasing the second load's mem_read before EX/MEM could
    capture it. The branch then compared a stale/zero value, making the
    scheduler select the wrong task (idle/prio=0 outranked task A/prio=2).
    FIX: decode_stage priority is now reset > hold > stall > flush > capture.
    A frozen bundle survives the hold, and the haz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
    [decode_stage.v, tb_soc_rtos.cpp]
2026-08-20 FreeRTOS: mark phases 1-2 done, document scheduler timing numbers
    tb_soc_rtos now stamps cycle counts on each task event: task A ticks
    at exactly 25.05M cycles apart (500ms @ 50MHz), task B prints at
    60.09M (1200ms), so vTaskDelay + CLINT tick are both cycle-accurate.
    Also records the load;load;branch pipeline fix that the scheduler
    bring-up exposed (decode_stage hold vs stall priority) and updates
    AGENTS.md with the H FreeRTOS status.
    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
    [tb_soc_rtos.cpp]
2026-08-20 Polish: code cleanup, refresh docs and Vivado numbers, drop stale TBs
    RTL: fix a comment typo in decoder.v and remove an unused temp reg in
    alu.v (no behavior change; tb_alu 42/42, tb_decoder 47/47 still pass).
    Workspace: delete untracked testbenches that were exact duplicates
    (tb_soc_top == tb_soc_top_uart, tb_l1_dcache == tb_cache,
    tb_l1_icache == tb_icache) and a stale failing dual-core boot TB; remove
    root-level VCD/jou/log artifacts.
    Docs: mark Phase A done in the roadmap, add the FreeRTOS row and phase H
    to the README, and refresh the synth/impl numbers from a fresh Vivado
    2026.1 run (synth 7,669 LUTs / WNS +3.348ns; impl 7,516 LUTs /
    WNS +0.685ns → Fmax 51.8MHz). TODO.md now track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
    [alu.v, decoder.v]
2026-08-24 Machine software interrupts: FreeRTOS semaphores now work from an ISR
    The CLINT gains an msip register (0x0200_0000) and the CPU takes machine
    software interrupts (mcause 0x80000003) alongside timer interrupts. A
    FreeRTOS app gives a semaphore from the ISR and wakes a blocked task,
    verified 3/3 times at exact 200ms spacing by the new tb_soc_rtos_sem.
    Full regression stays green, including compliance 53/54.
    Assisted-by: Crush:ox-alpha-free
    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
2026-08-25 FreeRTOS scheduler metrics + fix interrupt mepc during redirects/loads
    R1c: measure the three quotable numbers on the APU with mtime stamps —
    ISR entry latency 92 cycles avg (1.84us), 2-switch taskYIELD round trip
    492 cycles avg (9.84us), tick deltas 49,806-50,192 over 1200+ ticks
    (tb_soc_rtos_metrics, app firmware/apps/rtos_metrics.c). Enables the
    tick hook kernel-wide with a weak default hook in rtos/omni_libc.c.
    Enabling the tick hook shifted the kernel's code layout and exposed a
    real pipeline bug: an interrupt taken while a branch redirect was
    resolving or while a load sat in MEM (its forwarded value feeding the
    EX instruction) captured an inconsistent (mepc, register) pair, so the
    t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
    [cpu2_top.v, cpu_top.v, dual_core_top.v, exec_stage.v, fetch_stage.v, rtos_metrics.c, rtos_q.c]
2026-08-25 UART RX in RTL: deserializer, 16-byte FIFO, echo app (R2)
    uart.v is now full duplex. uart_rx is 2FF-synchronized into a
    deserializer that validates the start bit with a mid-bit resample
    (short glitches rejected), samples 8 data bits LSB-first at bit centers,
    and pushes completed frames into a 16-deep RX FIFO. New registers:
    +0x04 STATUS gains rx-ready and a sticky overrun flag; +0x08 RXDATA pops
    one byte per read and clears overrun. FIFO occupancy uses an explicit
    5-bit counter - the natural 4-bit pointer comparison cannot tell full
    from empty at depth 16, which the unit TB caught immediately.
    Firmware gains uart_getchar()/uart_status(); apps/uart_echo.c retransmits
    everything received. Two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
    [cpu2_top.v, dual_core_top.v, soc_top.v, tb_soc_uart_rx.cpp, tb_uart_rx.cpp, uart.c, uart.h, uart.v]
2026-08-25 Interactive FreeRTOS shell in simulation: type at the APU over UART (R3+R4)
    You can now type commands into a FreeRTOS shell running on the SoC inside
    Verilator, over a full-duplex UART fed from stdin at real 115200 baud
    framing. This is the demo piece: one session exercises CPU pipeline, RTOS,
    SoC integration, and launches a GPU kernel over MMIO.
    - firmware/apps/shell.c: console task with echo/backspace line editing and
    help/uptime/ps/ticks/gpu/quit commands. ps uses uxTaskGetSystemState
    (configUSE_TRACE_FACILITY=1); ticks reads live tick-jitter stats from a
    strong tick hook; gpu reuses the Phase-F host window (vector-add
    checksum PASS over MMIO); quit prints a marker the TB decodes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
    [shell.c, tb_soc_shell.cpp]
2026-08-25 Package the shell demo; fix UART decode aliasing the GPU page it exposed
    The interactive-shell demo is now in the README as a GIF rendered from a
    real simulation capture (every byte is sim output; only typing speed is
    synthesized), plus a replayable asciinema recording and a demo-generator
    script.
    Capturing the demo exposed one last real RTL bug: the transcript carried a
    stray NUL byte before the gpu command's response. VCD forensics traced it
    to an address-decode alias in uart.v - its select only excluded bit 12
    (GPIO), so the GPU page at 0x40002000 (bit 13) also selected the UART, and
    gpu_launch's WARP_PC0 write (offset +0x00, same as the TX register)
    reloaded the TX shift register mid-fr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
    [make_shell_demo.py, tb_soc_shell.cpp, uart.v]
2026-08-25 Docs audit: current-state architecture + GPU design; history docs moved
    The docs still described the project as planned, not as built: the
    architecture page claimed an AXI4-Lite interconnect (the design uses a
    simple pbus MMIO decode - no AXI exists), listed finished phases as "in
    progress", and the GPU design page was an empty TODO placeholder.
    - docs/architecture.md rewritten as a current-state reference: real
    top-level structure (soc_top, pbus, CLINT interrupts), CPU pipeline
    contracts (mem_hold for registered BRAM reads, interrupt-safe window),
    cache gating, the 2-core MSI rig, GPU summary, software stack
    (boot/drivers/FreeRTOS/shell), verification matrix and measured PPA.
    - doc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
2026-08-25 Shell debug-monitor commands (peek/poke/mdump/gpio/mtime/heap/reboot) + live console wrapper
    The interactive shell now behaves like a U-Boot-style debug monitor on the
    bare-metal FreeRTOS: peek/poke word access, mdump, GPIO write+readback,
    the 64-bit CLINT counter, FreeRTOS heap usage, and a real reboot (jump to
    the reset vector; startup.S resets sp and re-zeroes .bss). scripts/console.sh
    puts the terminal in raw mode so the session feels like a serial console
    instead of a pipe. tests/test_shell.sh grew to 17 assertions, all green.
    Debugging reboot surfaced two real traps for the interview folder:
    - csrci mie, 0 is a no-op (clears zero bits), so FreeRTOS's MTIE|MSIE
    survived the jump; the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
    [shell.c]
2026-08-26 GPU completion interrupt: warp-halt raises MSI, shell waits on semaphore
    The gpu command no longer spins on STATUS: gpu_cmd_proc latches a done
    bit when active_warps falls to zero (combinational-clear on STATUS read),
    timer.v ORs it into msip, and the FreeRTOS MSI handler posts a binary
    semaphore that the shell's gpu command blocks on (1s timeout, poll
    fallback). Adds a weak default ISR in omni_libc.c (clears msip, returns)
    so non-shell apps stay link-clean. Gate asserts "irq=1" proving the
    interrupt path fired; full regression green.
    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
    [dual_core_top.v, gpu_cmd_proc.v, gpu_top.v, shell.c, soc_top.v, timer.v]
2026-08-26 Add GPU BARRIER warp-sync instruction + fix Vivado-rejected !| expression
    The SIMT engine can now synchronize its four warps with a BARRIER opcode
    (0x6): the warp scheduler parks each arriving warp in a WAIT state and
    releases the whole group once every active warp has arrived, so a lone
    warp passes immediately and a group that never converges deadlocks (the
    same undefined behavior as CUDA). Covered by a new marker kernel that
    checks no deadlock plus PRE/post-barrier-read/POST markers in every
    warp's scratchpad, and by a single-warp no-deadlock diag. tb_gpu_top_kernels
    118/118, GPU unit TBs, tb_soc_gpu, and the shell gate all pass.
    Also fix the GPU completion interrupt's `!|active_warps` ex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
    [gpu_asm.py, gpu_cmd_proc.v, gpu_decode.v, gpu_top.v, warp_scheduler.v]
2026-08-26 Expand README: testbench workflow, shell usage, GPU ISA, docs index
    Make the repo approachable to a fresh reader: document how the Verilator
    C++ harnesses work (TB-to-DUT mapping, pass/fail exit codes, waveforms,
    adding a new testbench), the interactive FreeRTOS shell (commands, live
    console, scripted gate), and the 16-bit SIMT GPU ISA plus the kernel
    assemble/load workflow. Add a docs index table and refresh the
    verification and area numbers (impl: 7,639 LUTs, WNS +1.253 ns ->
    Fmax ~53.4 MHz).
    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
2026-08-26 Fix doubled characters in the live shell terminal
    tb_soc_shell echoed every stdin byte to stderr and the shell firmware also
    echoed it via UART TX to stdout, so a live console.sh session showed each
    character twice, and control bytes (backspace 0x7f, tab 0x09) appeared as
    literal "\xNN" text instead of being handled by the shell's line editor.
    The stderr echo is now suppressed when stdin is a real TTY (isatty), where
    the firmware's own echo is the only one; piped sessions (test_shell.sh)
    are unaffected. Backspace now erases visibly; tab remains unsupported
    (no completion, silently dropped) and is documented in the README.
    💘 Generated with Crush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
    [tb_soc_shell.cpp]
2026-10-06 Fix firmware build with current toolchains; package the shell demo
    Three real defects kept shell.hex from building or booting under CachyOS riscv64-linux-gnu gcc 16.2.1 / binutils 2.47:
    - binutils 2.47 rejects the linker scripts: without explicit PHDRS, ld synthesises a PT_PHDR segment for the ELF headers and errors "PHDR segment not covered by LOAD segment" (the older toolchain only warned). Declare the segments explicitly; the flat image is unchanged (entry 0x0, .bin starts at _start).
    - The Linux-targeting cross gcc defaults to -fPIE, which turns la sp, _stack_top into a GOT-relative load (auipc+lw from .got) and leaves gp/GOT state nothing initialises on bare metal: the image boots, pr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
2026-10-12 Firmware track: generic console testbench + F1 gate pair
    F0 rig: hardware/sim/soc/tb_soc_console.cpp runs ANY firmware image (no banner requirement), decodes UART TX at real 115200 framing onto stdout, feeds stdin onto uart_rx with burst or line pacing, and ends on an end marker, on stdin EOF + quiet, or on a cycle cap (exit 1). tests/run_app.sh builds, stages and runs an app with build chatter on stderr so stdout is pure firmware output; tests/check.sh is the shared assertion helper.
    firmware/Makefile: every lib/*.c is compiled with -fno-builtin and linked into the NON-RTOS apps (RTOS apps keep rtos/omni_libc.c, so no duplicate memcpy), include/ joins the include path, and gates inject def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
2026-10-12 tests/check.sh: show why a gate failed
    A failing gate printed only the check names, so a build error looked identical to a wrong answer. check_pass now dumps the firmware's [TEST] FAIL lines and SUMMARY (or, when the app never ran, the tail of the log where the compiler errors are) before exiting non-zero. Verified against both branches with synthetic logs.
2026-10-12 F2 gate: printf vectors with the host C library as the reference
    Interface given: firmware/include/omni/stdio.h - vsnprintf/snprintf/vprintf/printf, the supported subset, and the C99 truncation contract written out (at most n bytes incl. NUL, always terminate when n > 0, nothing written when n == 0, return the would-be length).
    tests/gen_printf_vectors.py emits the shared case table (corner cases plus a seeded random batch) and a host runner that executes the SAME cases through the host libc's snprintf, writing per-case expectations (ret, whether anything outside the written region was touched, output bytes) and the expected stream bytes. glibc is the authority, so the gate tests the C stan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
2026-10-14 F2 complete: printf engine, and the shell now formats through it
    firmware/lib/omni_printf.c implements vsnprintf/snprintf/vprintf/printf to the contract in include/omni/stdio.h: characters are counted after the buffer fills so the return value is the length that WOULD have been written, at most n bytes are touched (none when n == 0), and the awkward rules match the C library exactly (0 flag ignored once a precision is given, '-' beats 0, '+' beats space, '#' prefixes only a non-zero value, precision 0 with value 0 emits no digits). 32-bit arithmetic throughout: no libgcc in this link, so a 64-bit divide would be an undefined __udivdi3.
    Unlike F1's library, this one is wired into the RTOS pa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
2026-10-14 F3 complete: UART software receive path, and three harness fixes it exposed
    firmware/drivers/uart_rx.{h,c}: a power-of-two ring fed by uart_rx_pump, uart_rx_read/getline with rollover-safe mtime timeouts, and counters for staged/dropped/overruns. Two details are load-bearing: the pump reads STATUS before every RXDATA read (reading RXDATA clears the sticky overrun, so an overrun mid-drain would otherwise vanish), and it deliberately does not call uart_init() - that clears the sticky flag by reading RXDATA, which pops a byte, and ate the first character of a paced line.
    Getline treats CR as part of the terminator and only LF as the line end; returning on CR left the LF in the ring and the nex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
2026-10-14 F4 complete: framed host protocol, and a simulator as its reference
    firmware/net/frame.{h,c}: FLAG-delimited frames (len seq cmd payload crc16-CCITT), SLIP-style escaping of 0x7E/0x7D, and a receiver that never delivers a frame it could not validate - a bad CRC or an impossible declared length gets a NAK and the frame is dropped. Duplicate sequence numbers are answered again rather than re-executed (a repeat means our answer went missing; idempotence is the point). Counters cover ok/bad_crc/bad_len/resync/dup/tx, and CMD_STATS reports them.
    tests/gen_frame_session.py builds the session AND the expectation by simulating the receiver byte for byte - hand-counting the counters is how you end u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
2026-10-14 F6 complete: fault diagnostics, and what this RTL actually raises
    Until now every trap went to timer_int_handler(), so an illegal instruction or a bad load silently became 'advance the timer' and the firmware carried on with corrupted state. boot/fault.c splits the path: trap_dispatch() routes interrupting causes (bit 31) to the timer handler exactly as before, and exceptions to fault_report(), which decodes mcause into a name, prints mcause/mepc/mtval plus the 28-register frame the trampoline saved, counts faults, treats ecall from M-mode as a deliberate semihost exit (the DONE marker ends the simulation), and parks instead of returning into a corrupt machine. boot/trap_handler.S now passes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
2026-10-14 F7 complete: time and software timers, driven by the machine timer interrupt
    firmware/drivers/tick.{h,c}: ticks_us/ticks_ms built on the CLINT's mtime, delays that spin (this core has no wfi), and a software timer table (one-shot and periodic) dispatched from tick_isr(), which boot/fault.c's trap_dispatch routes MTI to when the service is enabled - an app that programs the CLINT by hand keeps its own path. timer_fires/late/max_late_us report how well it kept up, and tick_elapsed() is the rollover-safe difference, unit-tested at the 32-bit boundary because mtime's low word wraps every ~86 s.
    Three bugs of mine surfaced getting it green, two of them the same lesson this track keeps teaching: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
2026-10-14 F8 complete: kernels are loaded into the GPU at run time, not at synthesis
    RTL: gpu_fetch gets a write-only host port (imem_we/addr/data; no reset, so the array stays RAM-inferable). gpu_cmd_proc gets IMEM_ADDR (0x4000_2024, RW, 10-bit word index) and IMEM_DATA (0x4000_2028: a store installs that word at the pointer and advances it), so a loop pushes a whole kernel the way memcpy would. Its write decode widened from 5 to 6 bits, which also fixes a latent alias: a write to +0x20 used to decode as +0x00 and clobber warp_pc[0].
    Firmware: drivers/gpu_loader.{h,c} push an assembled word array and then wait for completion on the interrupt - the GPU's done latch raises a machine software interrupt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
2026-10-14 Docs: the firmware track is finished, and what each phase cost
    docs/plan_firmware_track.md: F0-F8 are shipped and green, with the gate list as it actually runs (F3's gate is test_uart.sh, not test_uart_burst.sh; F5 reports 'allocator: ALL PASS (12 checks)' rather than an [ALLOC] line). Section 6 was an empty template; it now carries the traps that actually cost time per phase - the per-call ERANGE state and strncmp's bound-first rule in F1, glibc as the oracle plus -fno-builtin for F2, deliberate FIFO overruns to prove the loss accounting in F3, a byte-level receiver simulator in F4, heap_check after every operation in F5, the RTL's actual exception set in F6, mie/mstatus and the 64-bit-divi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
2026-10-14 Characterize the APU in cycles, and fix the counters that made it impossible
    There is no board and no Vivado here, so the measurable thing is what the RTL is, cycle for cycle. Writing the harness exposed an RTL bug first: mcycle (0xB00) and minstret (0xB02) were declared, readable and writable but never INCREMENTED - csr_file only assigned them on an explicit CSR write - so the core advertised performance counters that did not count. mcycle now free-runs (incremented before the write_en case so an explicit write still wins); tb_cpu_top still passes. minstret is deliberately left uncounted: it needs a real instruction-retired signal, wb_stage exposes none, and guessing one would produce a CPI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
2026-10-14 A real workload: a 2-layer MLP with the GPU kernel reloaded between launches
    y = relu(W2 . relu(W1 . x)) with integer 2x2 matrices, four samples computed at once (one per SIMT lane, each lane its own scratchpad bank). The firmware pushes matmul into the GPU's instruction memory, runs it, pushes relu over the top, runs that, then goes back to matmul for layer 2: four launches, four loads, two different kernel images, with the CPU staging each layer's operands through the shared-memory window in between. Before F8 this was impossible - the image was flashed at synthesis time and never changed.
    The result is checked, not admired: the app computes the same MLP scalar in C from the same weight/i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
2026-10-14 CI: run the RTL testbenches and the firmware gates on every push
    Two parallel jobs, because the Verilator builds are the slow part. rtl: tb_alu and tb_cpu_top. firmware: install Verilator and the riscv64 cross toolchain, probe that it can build rv32im/ilp32 (the whole firmware track is rv32, and a runner without multilib should fail with that one fact rather than forty confusing errors), build obj_dir_tb_soc_console - which tests/run_app.sh needs to exist - and obj_dir_tb_soc_shell, then run all eleven gates with ::group:: markers and a failure summary, then the shell session gate.
    Not yet exercised on GitHub's runners: this host has no network and no yaml parser, so the file is hand-checke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
2026-10-14 README: what was measured, what was not, and stop quoting a stale Fmax
    Two problems with the old README. First, it claimed 7,639 LUTs / WNS +1.253 ns / 53.4 MHz, which contradicts the post-R5 Vivado run recorded in AGENTS.md (7,516 LUTs, WNS +0.685 ns -> 51.8 MHz) - it was quoting an older synthesis. It now quotes the later run, names the date and tool, and says plainly that these numbers predate the runtime GPU kernel loader and have not been re-synthesised because there is no Vivado on the current machine.
    Second, it had no honest account of what the project has actually measured. A new section says everything is simulation (Verilator for cycles, Vivado reports for area/timing), that no b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
2026-10-14 Unified memory, step 2: the GPU gets a bus master and LDG/STG
    A kernel can now read and write the CPU's own arrays. LDG/STG (opcode 7) take a 32-bit address in rs1 through a new path: gpu_lsu exposes lane 0's full effective address (the access is warp-uniform, so one bus transaction serves the warp and a loaded word is broadcast), exec_lane forwards it, gpu_decode decodes the opcode, and gpu_asm.py assembles the mnemonics. The accesses leave through gpu_top's master port into the mem_arbiter M1 built, so the CPU's ordinary load/store address space and the GPU's kernels address the same bytes with no MMIO window between them.
    The handshake: a transaction starts as soon as the instruction is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
2026-10-14 Unified memory, step 3: the MLP ported onto shared memory, and it is not a win yet
    The workload now runs with no staging window at all: mlp_mem_test.c keeps its operands in an ordinary C array, two new kernels (matmul_mem.S, relu_mem.S) reach them with LDG/STG, and the app moves data between layers with plain C copies. Nothing goes through the MMIO host window.
    It does not work yet, and this commit says so rather than dressing it up: tests/test_mlp_mem.sh FAILS - all four samples are wrong - and it costs 15125 cycles against the MMIO window version's 6278 for the same four samples, i.e. 2.4x WORSE. tests/test_gpu_mem.sh passes, so the mechanism is sound for a simple kernel; the MLP port is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
2026-10-14 Unified memory, step 3 corrected: the shared-memory MLP passes, and is 2.4x slower
    The correctness bug was mine and it was a transcription slip: matmul_mem.S read B at byte offsets +16/+20 to compute c00 = a00*b00 + a01*b10, where a row-major B at +16,+20,+24,+28 needs +16 and +24. All four quadrants had the same off-by-one-word column index, which is why the results were wrong in a plausible-looking way rather than obviously broken.
    With that fixed tests/test_mlp_mem.sh is ALL PASS (8 checks): all four samples match the scalar reference, with the operands in an ordinary C array, the kernels reaching them with LDG/STG, layer-to-layer movement as plain C copies, and nothing through the MMIO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
2026-10-14 Reproducibility: a claims table, and one command that regenerates every number
    With no board and no Vivado, the only thing that makes a claim about this project worth reading is that a stranger can re-run it. RESULTS.md is that contract: every claim with how it was measured, the command that reproduces it, and what would falsify it. scripts/evidence.sh is the command - it prints the toolchain it used, rebuilds the console TB so a stale binary cannot pass, runs all fourteen firmware-track gates and four RTL testbenches, and always prints the simulation caveat even when everything is green (18 passed, 0 failed when last run).
    The CI workflow gained the guard it needed before its first run: th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
2026-10-14 CPI and the cost of a launch, measured where the counts are exact
    CPI is the headline microarchitecture number and this core cannot report it from its CSRs: minstret is readable but nothing increments it, because the pipeline has no instruction-retired signal. Plumbing one correctly means a valid bit through all four pipeline registers, which touches the hold/flush timing that has already produced two bugs here - so this measures CPI the other way round, where the instruction count is exact by construction: a 2-instruction taken-branch loop and a 64-instruction straight line. The gate re-derives CPI from the app's own printed cycles and counts rather than trusting its arithmetic.
    Results: 1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
2026-10-14 Fix: a global-access completion belongs to one warp, not to whoever asks next
    Four warps run the same kernel and can present the same global instruction, so g_done - once set - could be consumed by a different warp's instruction: that warp was then accepted on another warp's completion, taking the other's loaded data, and in the worst case a warp was left with no transaction of its own to complete at all, which shows up as a launch that never signals. g_done_warp tags the completion and only the owning warp is accepted.
    Found by the launch sweep producing an intermittent timeout, which is the useful part: the gate that failed had been passing, and the MLP and M3 gates passed too. Any result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
2026-10-14 Independent verification: a second toolchain, and formal properties instead of more tests
    Two things a board would normally supply, supplied another way. scripts/yosys_area.sh synthesises soc_top for XC7 with Yosys - an independent implementation that maps the same RTL to Xilinx primitives - so 'it synthesises' and 'it is about this big' stop being single-sourced from Vivado. Its numbers are explicitly not interchangeable with Vivado's (different memory/DSP inference), and it prints an install hint rather than failing obscurely.
    hardware/formal/ adds bounded model checking for the memory arbiter: the two masters are never acknowledged in the same cycle, an acknowledgement only ever goes to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
2026-10-14 Evidence covers the new gates, and a report draft in paper shape
    scripts/evidence.sh now runs test_cpi and test_launch_sweep too, so the closing sweep is 20 items rather than 18: sixteen firmware-track gates and four RTL testbenches, all passing on a clean run with the toolchain printed at the top and the simulation caveat printed even when everything is green.
    docs/report_draft.md is track D started: the technical content in paper shape - abstract, design, verification methodology (the part with generalisable content: reference models instead of chosen expectations, gates instead of demo programs, instrumentation to measure rather than to guess), the measurements, an explicit threats-to-va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
